Morfe0z/estacao_ar/fotos/README.md

# Fotos e capturas de tela

## Montagem
| Foto | O que mostra |
|---|---|
| Protótipo visto de cima | Protótipo completo na protoboard, visto de cima: ESP32 (esquerda), DHT22 (branco, em cima), BME280 (embaixo à esquerda), MQ135 (direita, LED vermelho), PMS7003 (verde, embaixo) e os resistores do divisor e do pull-up |
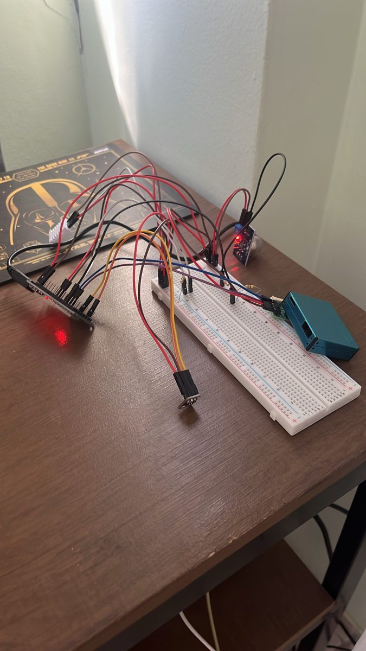
[picture p4: fotos/prototipo-protoboard-lateral.jpg]
Protótipo de lado
|  | O mesmo protótipo de lado, ligado e funcionando |
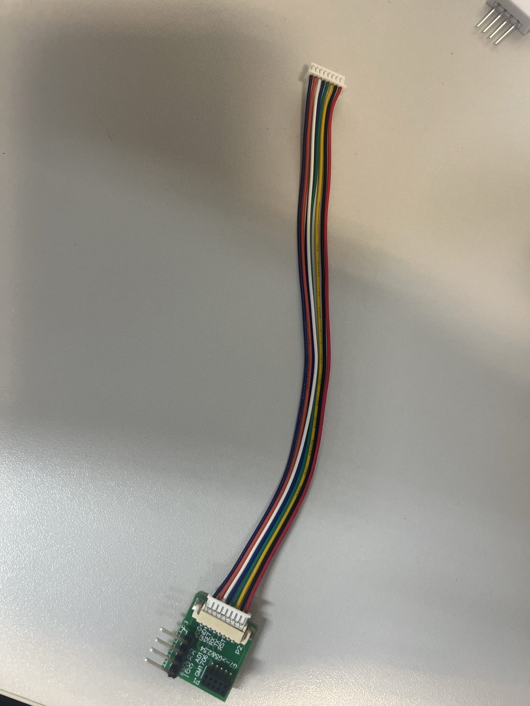
[picture p5: fotos/pms7003-adaptadora-e-cabo.jpg]
PMS7003 com adaptadora
|  | PMS7003 com a placa adaptadora e o cabo |

<!-- Fotos da montagem completa entram aqui: protoboard com todos os sensores, detalhe do divisor do MQ135,
     estação ligada na fonte, e depois a placa soldada e a caixa. -->

## Resultados de cada etapa (Monitor Serial e páginas)
| Etapa | Captura |
|---|---|
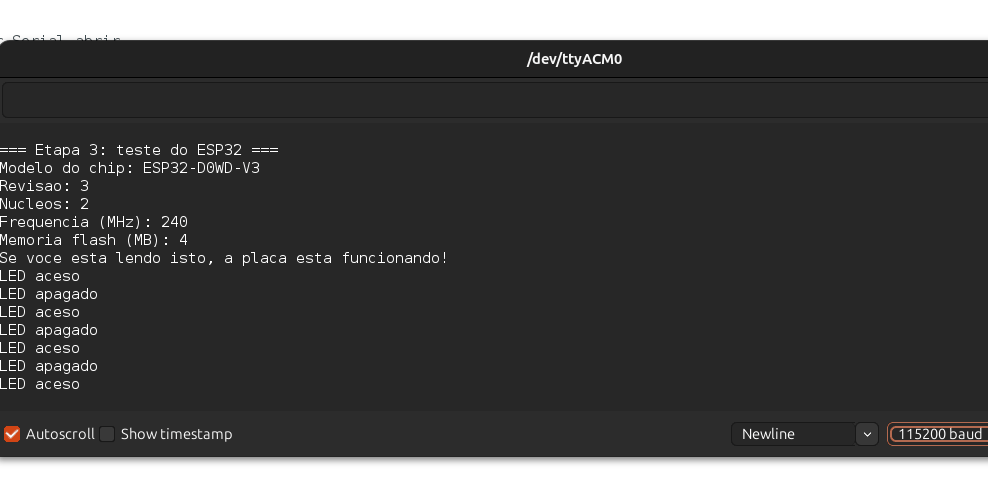
[picture p6: fotos/capturas/etapa03-esp32-monitor-serial.png]
Etapa 3
| 3. ESP32 sozinho |  |
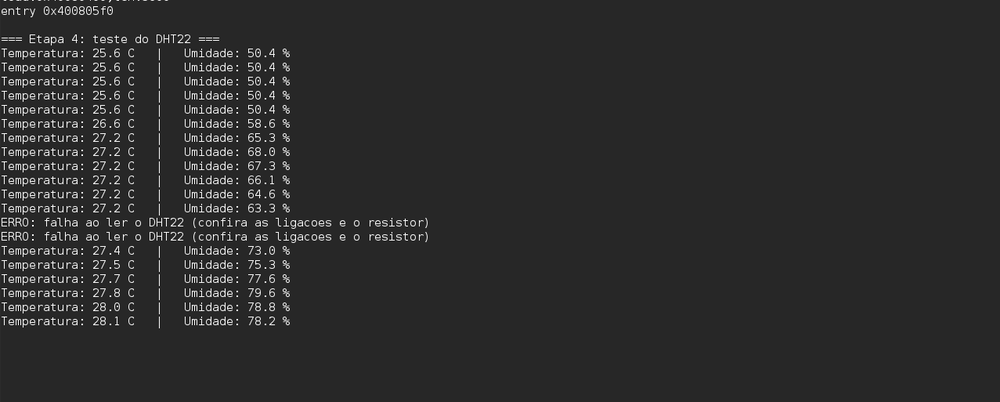
[picture p7: fotos/capturas/etapa04-dht22.png]
Etapa 4
| 4. DHT22 |  |
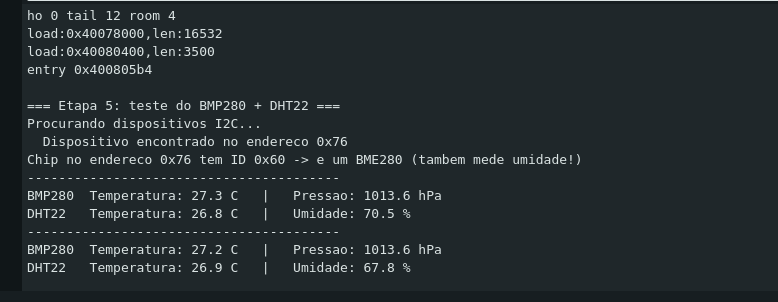
[picture p8: fotos/capturas/etapa05-bme280-identificado.png]
Etapa 5
| 5. Sensor I2C identificado como BME280 (ID 0x60) |  |
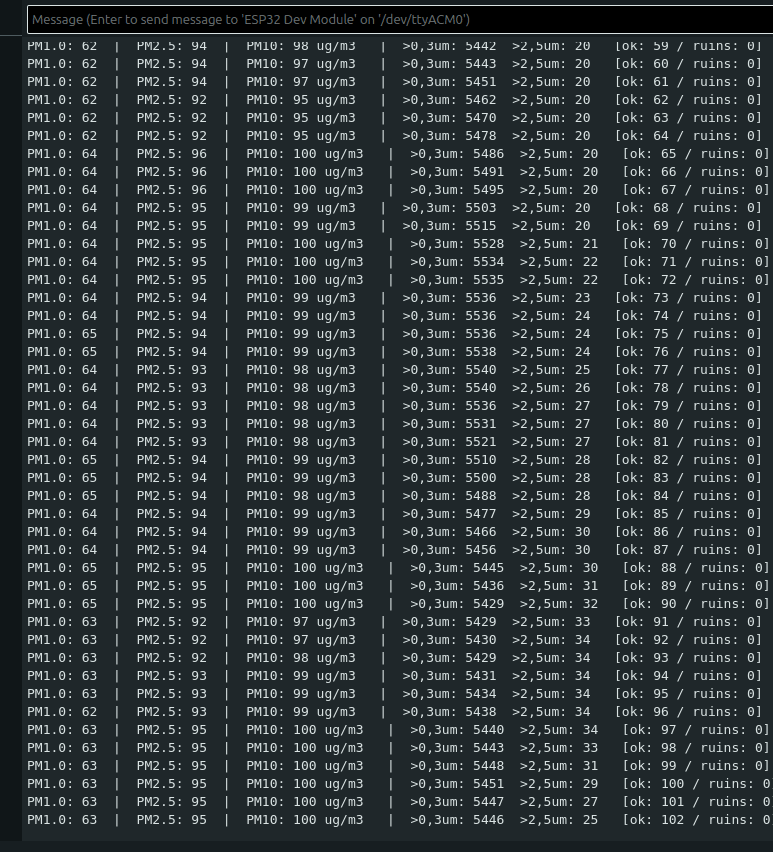
[picture p9: fotos/capturas/etapa06-pms7003.png]
Etapa 6
| 6. PMS7003 |  |
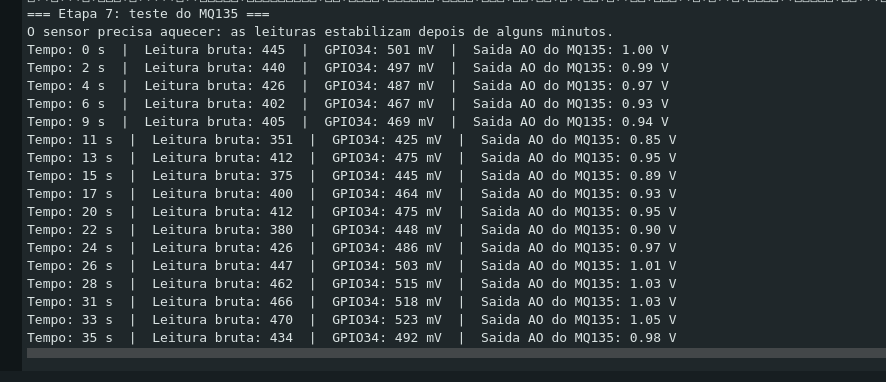
[picture p10: fotos/capturas/etapa07-mq135-aquecendo.png]
Etapa 7
| 7. MQ135 aquecendo |  |
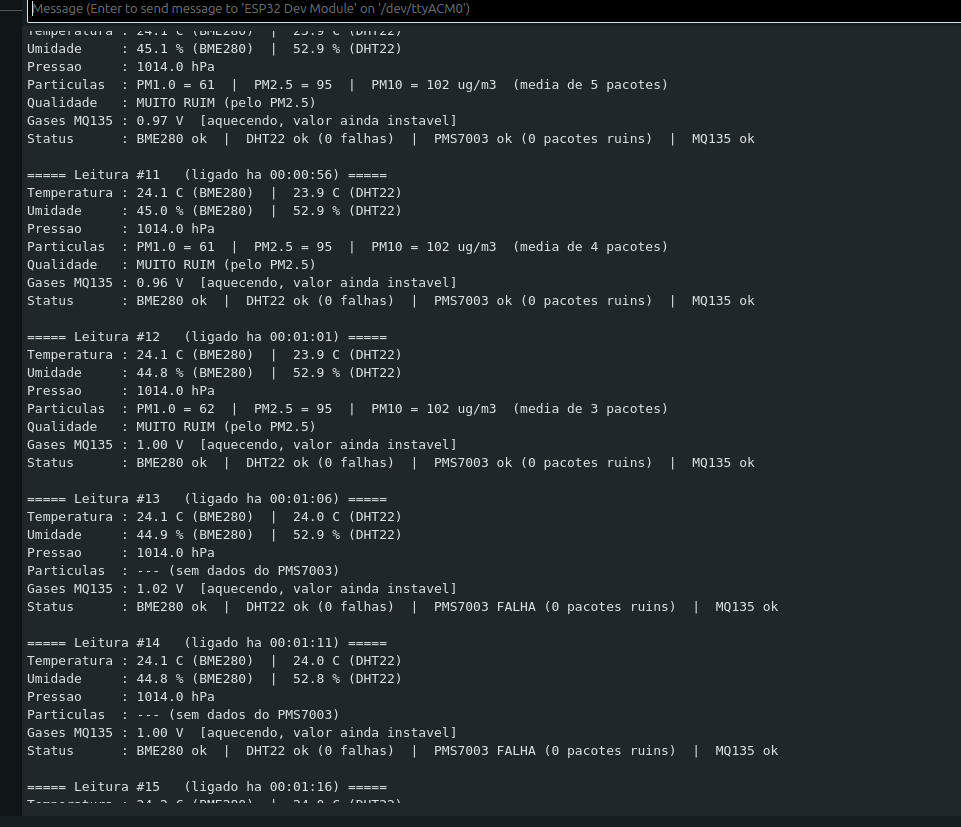
[picture p11: fotos/capturas/etapa08-estacao-integrada.png]
Etapa 8
| 8. Estação integrada (com o teste de tirar o fio do PMS) |  |
| 9. Página da estação no celular (http://192.168.4.1) | Etapa 9 |
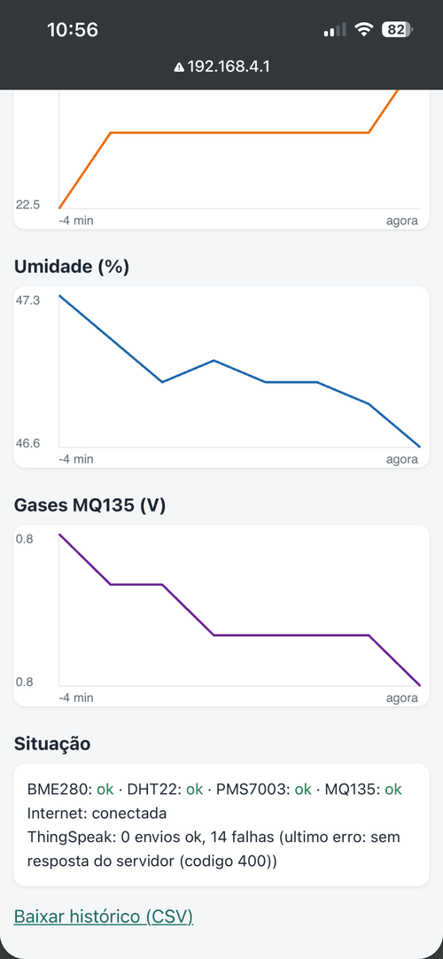
[picture p12: fotos/capturas/etapa09-erro-400-thingspeak.png]
Erro 400
| 9. Erro 400 do ThingSpeak (incidente de 09/10, ver [solução de problemas](../docs/solucao-de-problemas.md)) |  |
| Painel do ThingSpeak | Painel |
