Morfe0z/estacao_ar/fotos/capturas/kicad-k2-esquematico.png

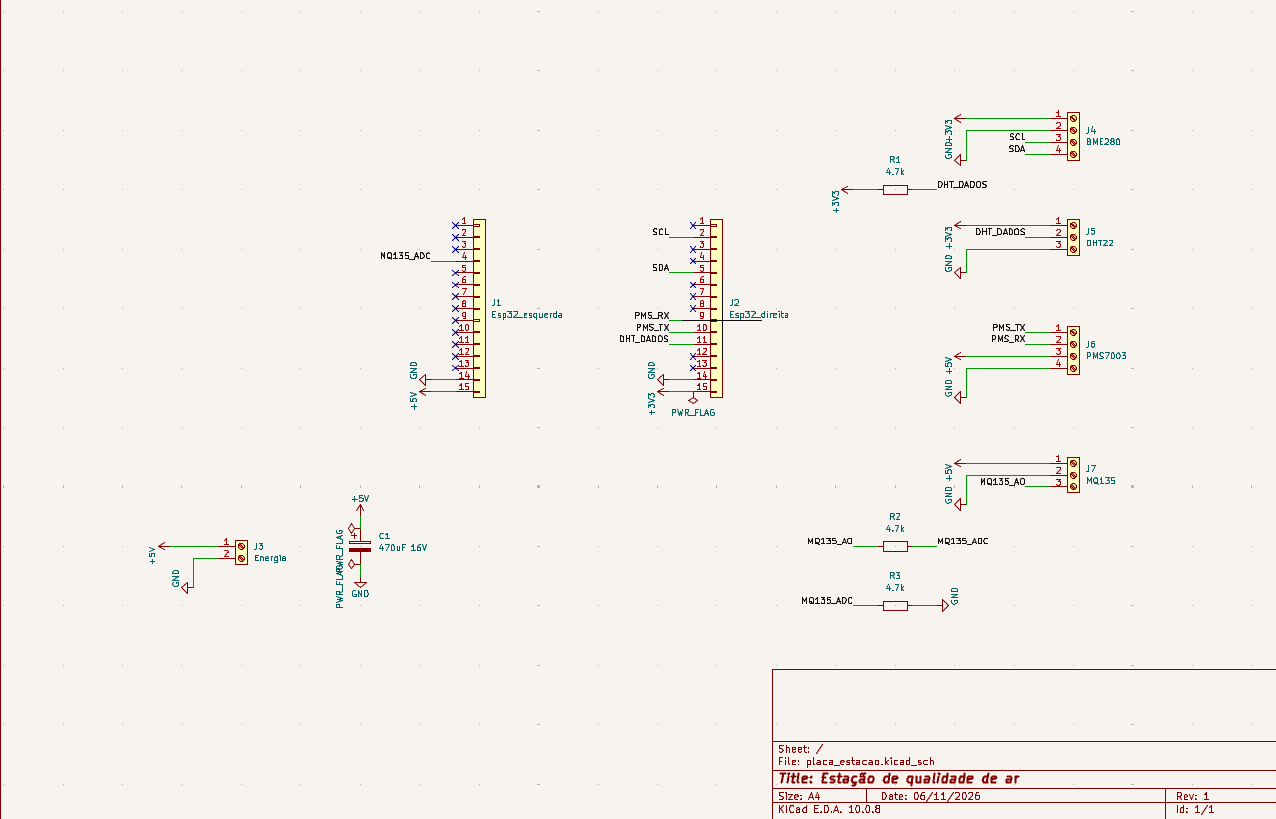
fotos/capturas/kicad-k2-esquematico.png
