Morfe0z/estacao_ar/fotos/capturas/kicad-k2c-erc-sem-erros.png

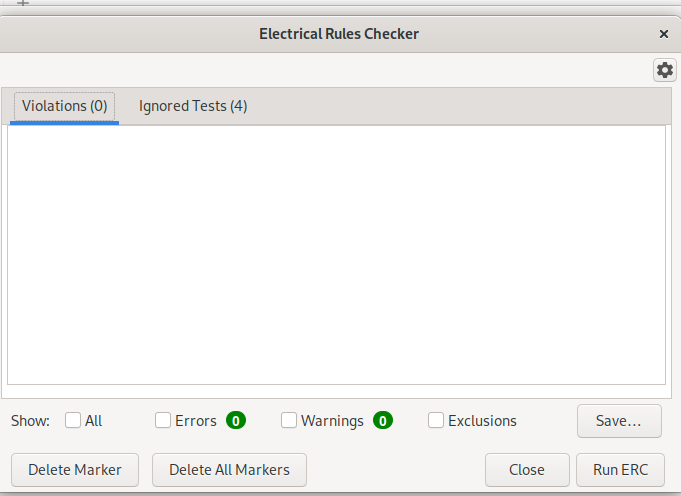
fotos/capturas/kicad-k2c-erc-sem-erros.png
