Morfe0z/estacao_ar/fotos/capturas/kicad-k3-erc-com-footprints.png

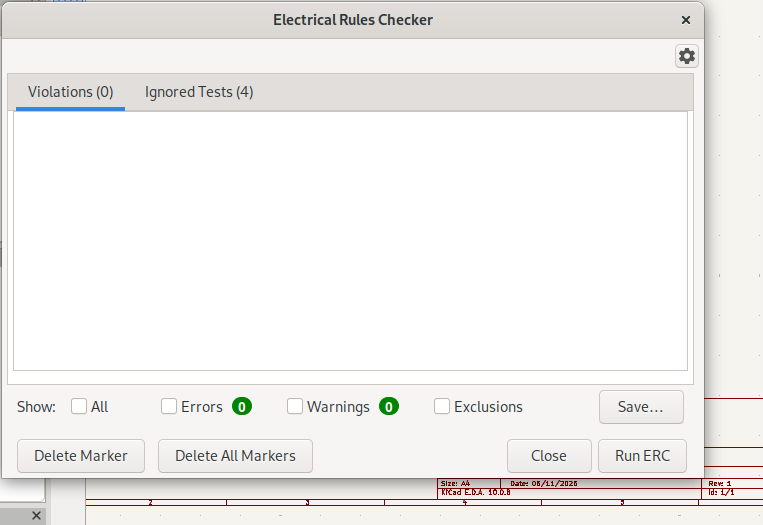
fotos/capturas/kicad-k3-erc-com-footprints.png
