Morfe0z/estacao_ar/hardware/lista-de-materiais.md

# Lista de materiais

## Protótipo (montado e funcionando)
| Item | Qtd | Detalhe |
|---|---|---|
| ESP32-WROOM-32 DevKit 30 pinos | 1 | micro-USB, chip USB CH343/CH9102, ESP32-D0WD-V3, 4 MB de flash |
| BME280 | 1 | módulo de 4 pinos, I2C (temperatura, umidade, pressão) |
| DHT22 | 1 | sensor solto de 4 pernas (temperatura e umidade) |
| PMS7003 | 1 | com placa adaptadora (usar o conector P3) |
| MQ135 | 1 | módulo VCC / GND / DO / AO |
| Resistor 4,7 kΩ | 3 | 1 pull-up do DHT22 + 2 do divisor do MQ135 |
| Protoboard 830 furos + jumpers | 1 | macho-macho e macho-fêmea |
| Fonte 5 V / 3 A com saída USB | 1 | alimenta pelo micro-USB |
| Cabo USB **de dados** | 1 | cabos só de carga não gravam |
| Multímetro | 1 | para conferir cada ligação antes de energizar |

## Versão de campo (ao ar livre, em compra/projeto)
Ver a lista completa e as peças para imprimir em 3D em [docs/estrutura-externa.md](../docs/estrutura-externa.md#8-lista-de-compras-estimativa).

| Item | Qtd |
|---|---|
| Caixa de passagem PVC IP65 ~150×110×70 mm | 1 |
| Prensa-cabos PG7/PG9 | 4 |
| Abrigo de radiação impresso em PETG/ASA branco (ou 6–8 pratos de vaso brancos) | 1 |
| Joelho PVC esgoto 75 mm | 2 |
| Placa perfurada ~7×9 cm (ou PCB fabricada) | 1 |
| Barras de pinos fêmea 15 pinos | 2 |
| Bornes KF301 de 2 e 3 vias (ou JST-XH) | 5 |
| Capacitor eletrolítico 470 µF / 16 V | 1 |
| Cabo 2 × 0,75 mm² (energia), cabo 4 vias e 3 vias (~1 m) | conforme o local |
