Morfe0z/estacao_ar/(commit log)

2026-10-10 Painel da estação de qualidade do ar
    Claude-Session: https://claude.ai/code/session_019UgmxrAfiH4stnMzXPhCor
2026-11-06 Organiza o projeto inteiro: etapas, firmware, ligações, fotos, dados e relatório
    - docs/etapas: guias das etapas 1 a 10b, com links para os programas
    - firmware: um sketch por etapa; senhas e chaves movidas para secrets.h
    (fora do git) com secrets.exemplo.h em cada pasta
    - hardware: diagrama de ligações em SVG, tabela de pinos e lista de materiais
    - fotos, dados (CSV do ThingSpeak), painel e relatório em PDF
    - index.html do GitHub Pages mantido sem mudanças
    Claude-Session: https://claude.ai/code/session_01Np7UZZrL8YS4qh4trTyshq
    [thingspeak_2026-10-08_a_2026-10-20.csv]
2026-11-06 Adiciona fotos do protótipo montado na protoboard
    Fotos sem metadados (EXIF removido) e reduzidas para 1200 px.
    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
2026-11-06 KiCad: índice das etapas, decisão de placa caseira por toner e regras de desenho
    Claude-Session: https://claude.ai/code/session_01Np7UZZMDAniaP2QEzWBqa9
2026-11-06 KiCad K2b: guia das ligações do esquemático com a pinagem real do ESP32
    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
2026-11-12 KiCad: esquemático completo da placa (K2b) em hardware/kicad
    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
    [placa_estacao.kicad_sch]
2026-11-12 KiCad K2c: ERC sem erros; prints do esquemático e do ERC
    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
2026-11-12 KiCad K3: footprints atribuídos no esquemático e guia com lista de compras
    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
    [placa_estacao.kicad_sch]
2026-11-12 KiCad K4a: guia de regras, contorno e posicionamento; K3 concluída
    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
